NosherwanA/Digital_Voltmeter/Schematic/Digital Voltmeter 20190416.pdf

# DIGITAL VOLTMETER

# TABLE OF CONTENTS

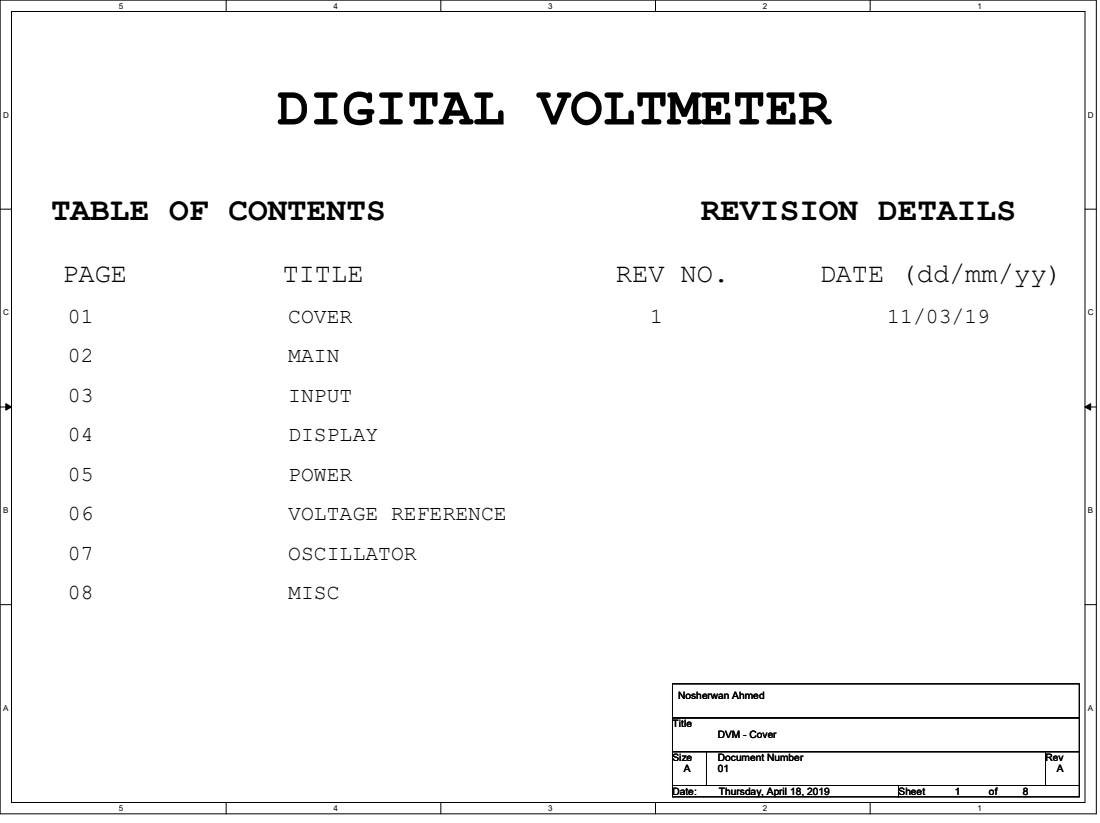
[picture p1: page 1]
PAGE; TITLE; COVER; MAIN; INPUT; DISPLAY; POWER; VOLTAGE REFERENCE; OSCILLATOR; MISC; REVISION DETAILS; REV NO.; DATE (dd/mm/yy); Title; Size; Document Number; Rev; Date:; Sheet; DVM - Cover; Nosherwan Ahmed; Thursday, April 18, 2019

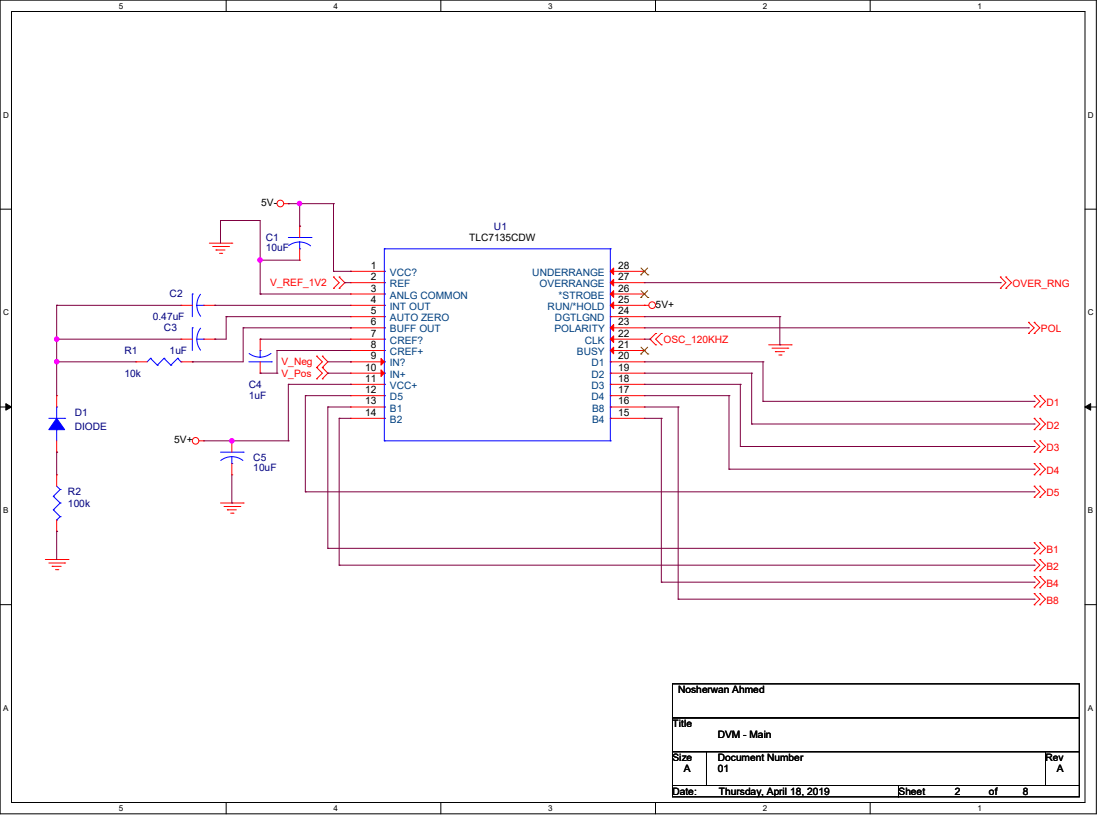
[picture p2: page 2]

## Hardware Switch

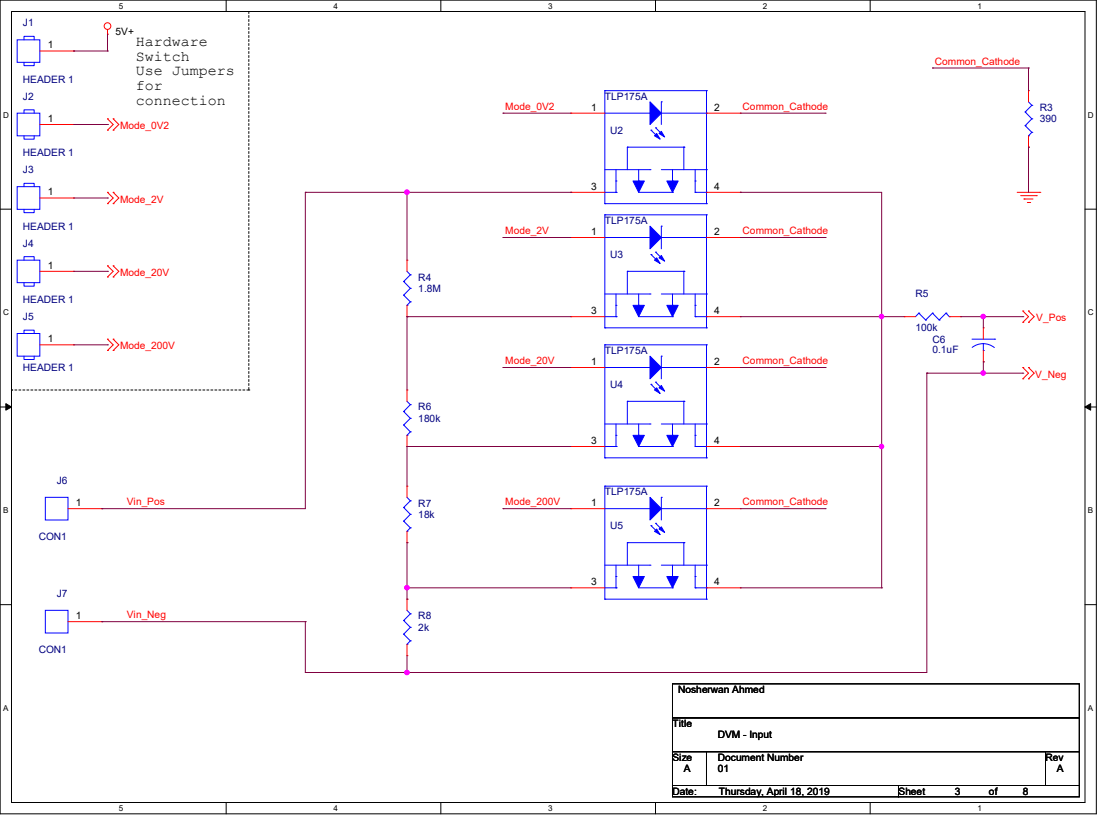
[picture p3: page 3]

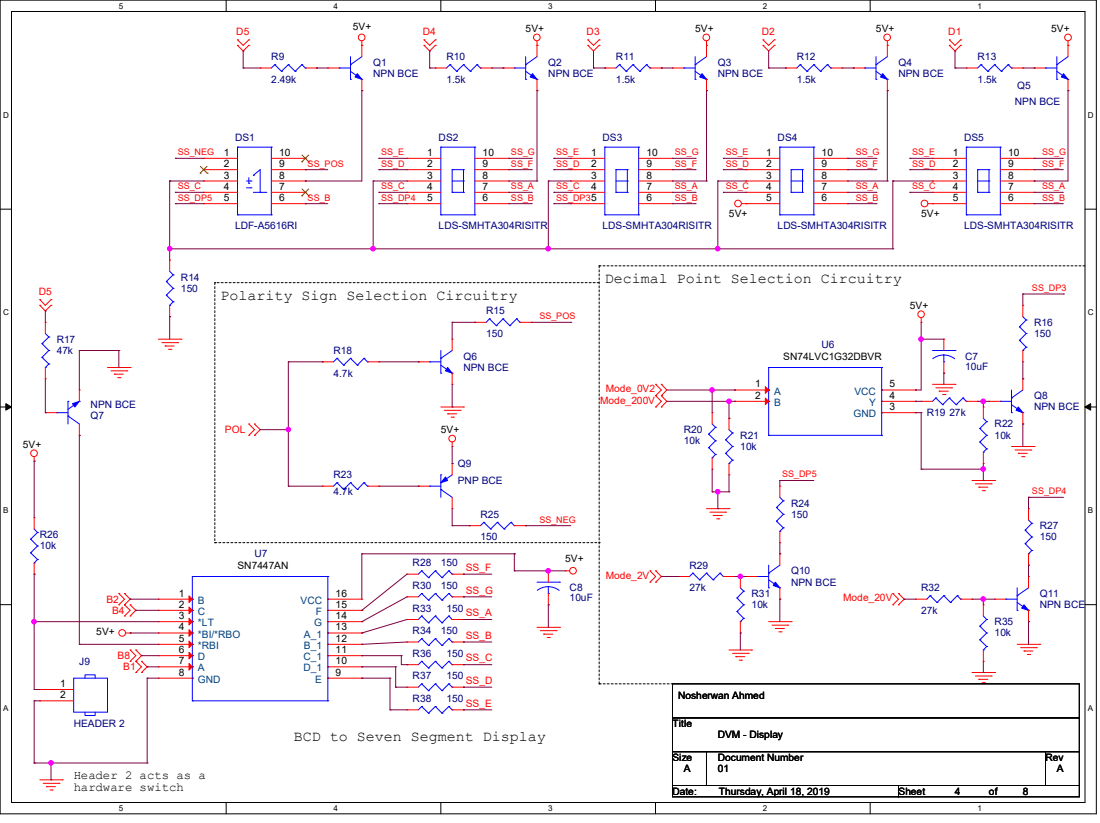
[picture p4: page 4]

Decimal Point Selection Circuitry

BCD to Seven Segment Display

### Header 2 acts as a

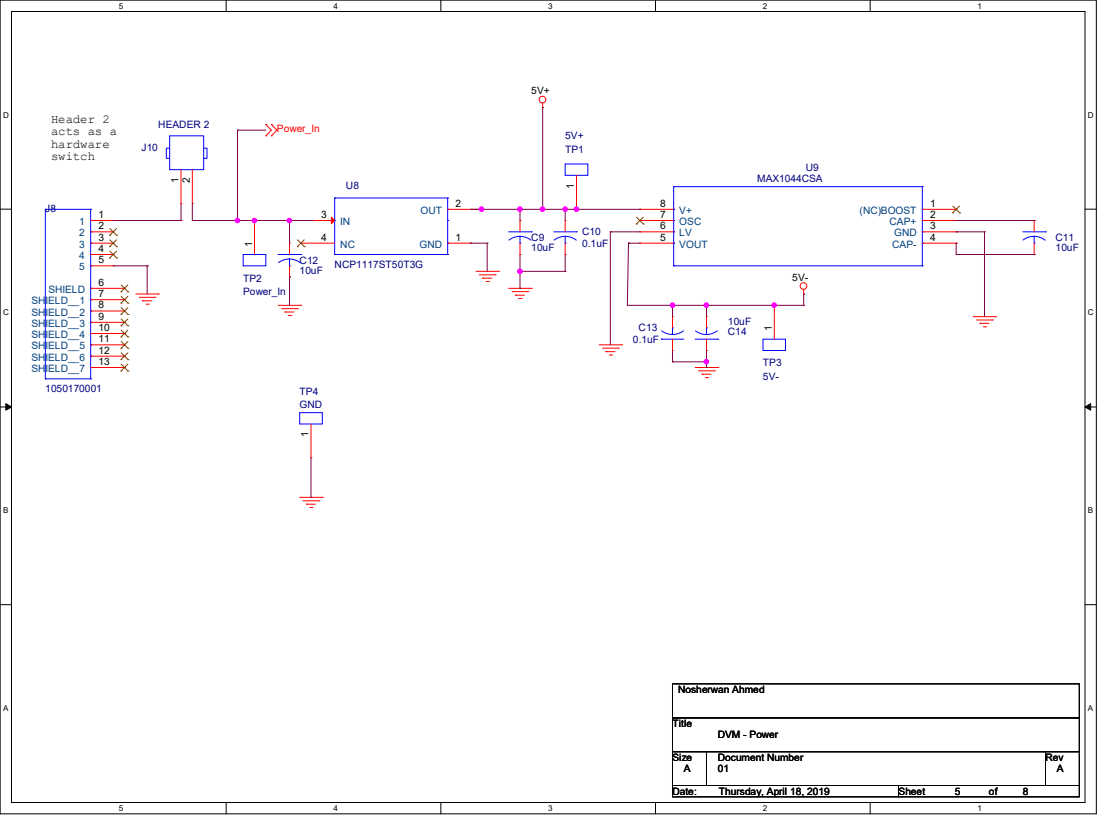
[picture p5: page 5]

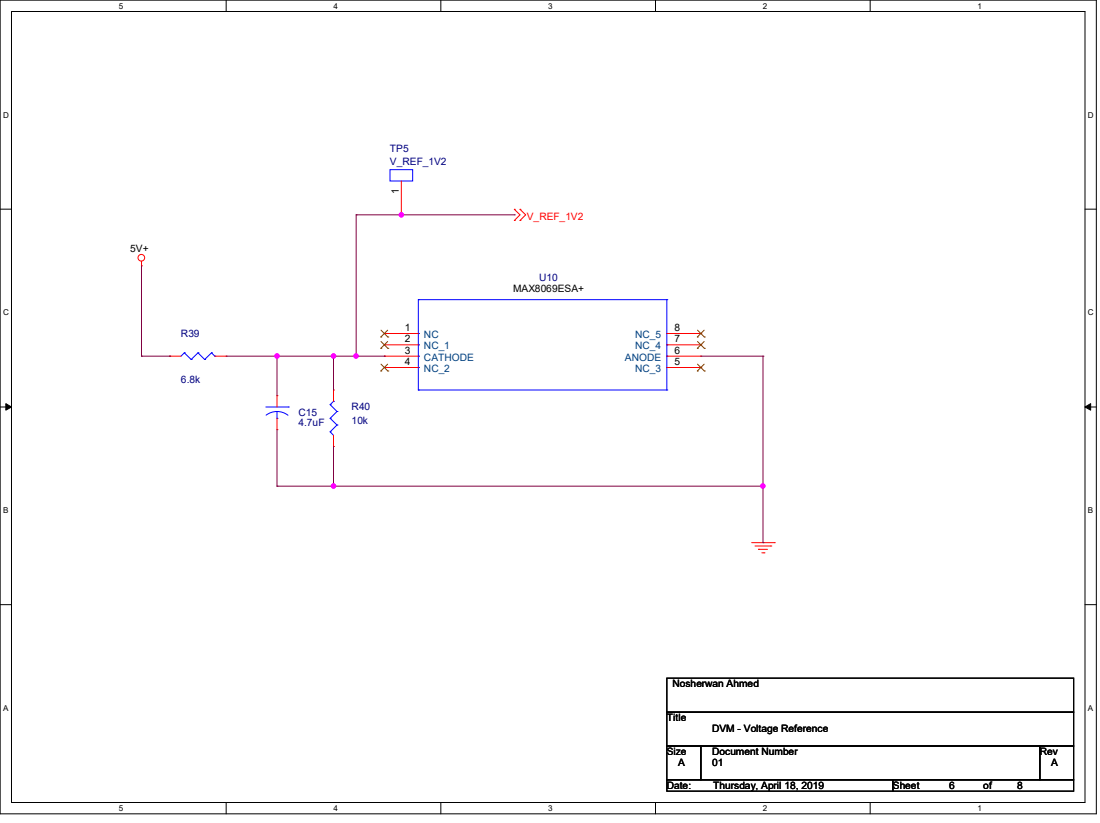
[picture p6: page 6]
V_REF_1V2; Title; Size; Document Number; Rev; Nosherwan Ahmed; Thursday, April 18, 2019; TP5 V_REF_1V2; U10 MAX8069ESA+; NC 1 NC_1 2 CATHODE 3; 5 ANODE

DVM - Voltage Reference

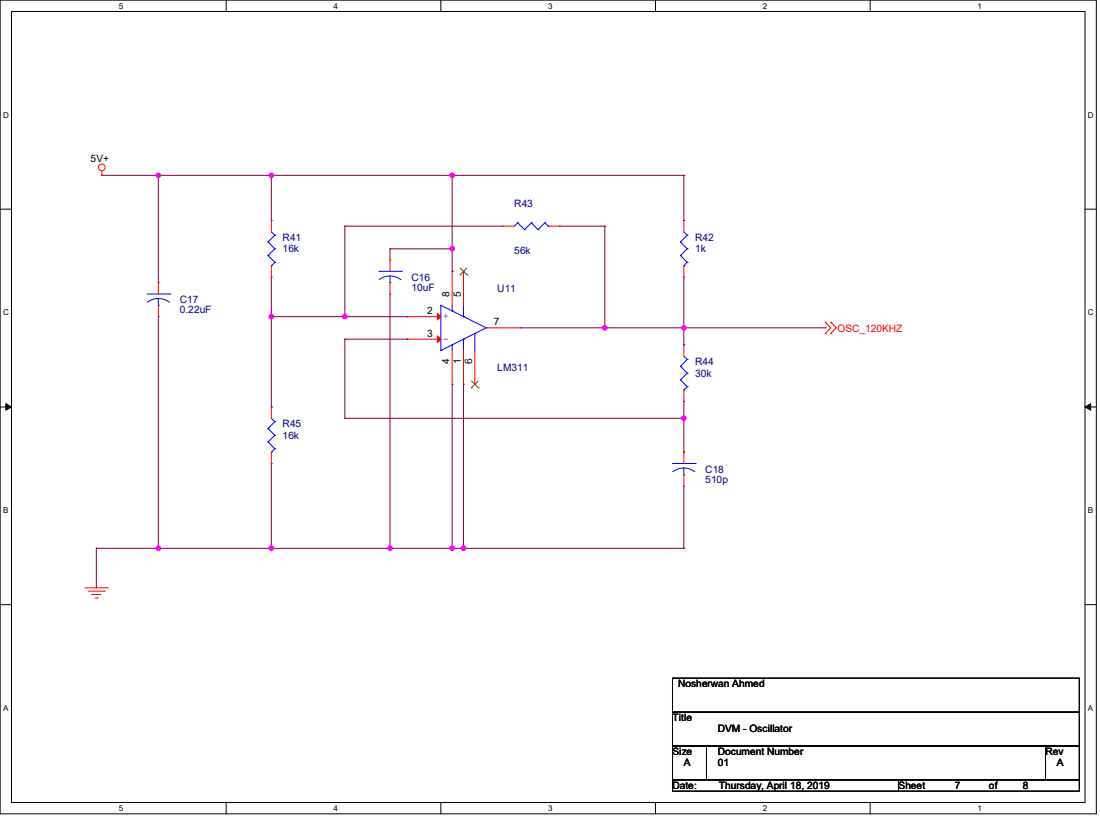
[picture p7: page 7]

# Status LEDs

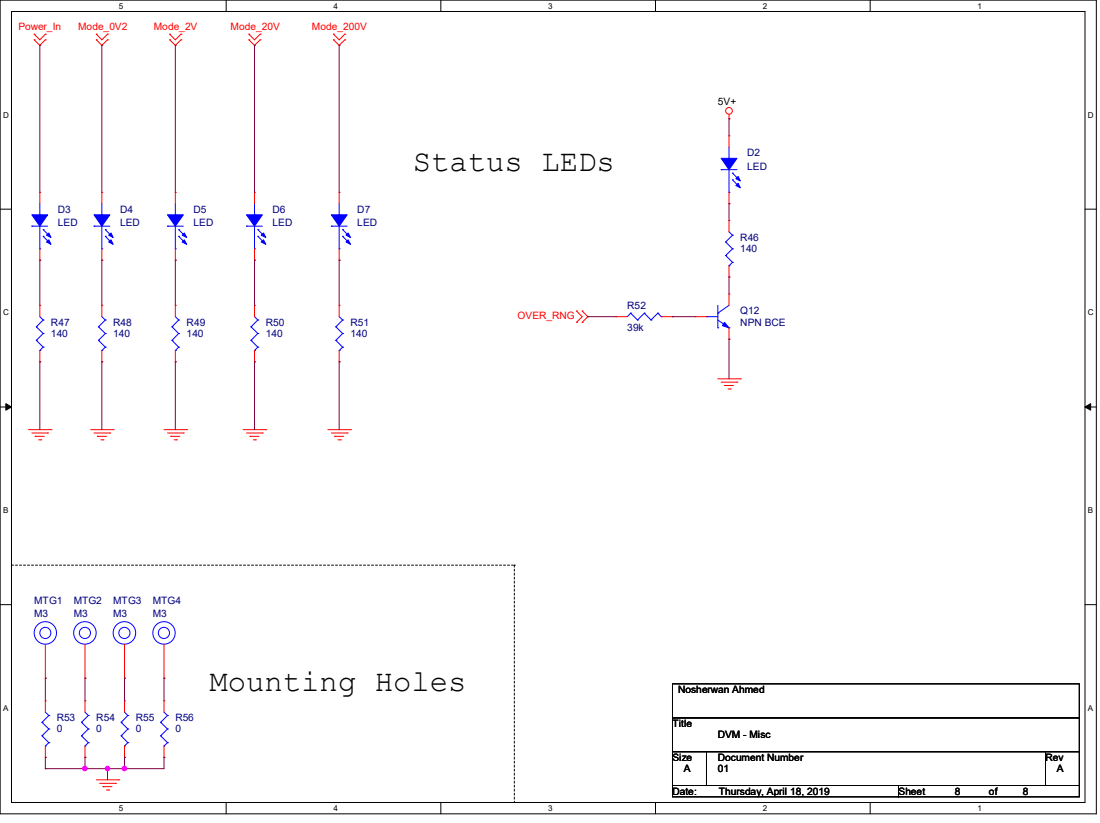
[picture p8: page 8]
