NosherwanA/Digital_Voltmeter/(list of files, drawings)

Other design files:
OrCAD Project Files/DVM.DSN
OrCAD Project Files/DVM.opj
