NosherwanA/Digital_Voltmeter/(commit log)

2019-03-12 Added schematic and BOM for the project
    [DVM_BOM.xlsx]
2019-05-20 Added 3D model, Gerbers, Layout, Project files, and updated BOM and Schematic
    [DVM.DSN, DVM.brd, DVM.opj, DVM_BOM.xlsx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]
